Yunqi2001/TJU-PCB-2023/README.md

# 🤖 PCB Project 2023

Hii, here is Yunqi 🤠, I'm a designer :)  
This is my PCB (printed circuit board) project at the D&I, Tongji University.

Here I will show you how I learn the basics of electronic circuits design, fabrication and programming, and create my own smart device to strengthen the bonds between humans and nature.

The main tools used include [EDA](https://pro.lceda.cn/editor) for circuit design, [Arduino IDE](https://www.arduino.cc/en/software) for embedded programming, and the small CNC milling machine and electronic components available at [Fablab Shanghai](https://www.fablabs.io/labs/ShanghaiFablab) laboratory.

If you wanna learn and create your own PCB from scratch, things here can be a good reference.  
**If you only want to learn about my final output, please open the "final project" folder directly.**

Thanks for watching! <3

你好！我叫李蕴琦 🤠，我是一个设计师 :)  
这是我的PCB（印刷电路板）项目，作为在同济设创大四studio的课程产出。
我将在这里向你展示我学到的电路设计，制作和编程的知识，以及我是如何用它们设计、制作我自己的智能设备，来加强人与自然的连接的。

主要用到的工具有[EDA](https://pro.lceda.cn/editor)来设计电路,[Arduino IDE](https://www.arduino.cc/en/software)来做简单的嵌入式编程, 以及[Fablab Shanghai](https://www.fablabs.io/labs/ShanghaiFablab)实验室里的小型数控铣床和电子元器件们。

如果想你像我一样想从零开始学习、制作你自己的pcb，这会是一个不错的参考。  
**如果你仅仅想了解我的作品，请直接打开最后一个 “final project" 文件夹。**

感谢观看 <3
