Yunqi2001/TJU-PCB-2023/06-actuators/README.md

# Actuators

## Description
Sensors are INPUT devices, actuactors are OUTPUT devices. 
We use sensors to collect data, and use actuactors to translate the data we get to something humans can feel and understand. 
In this tryout, we learned about some actuators such as servo motor and I2C crystal screen. 

## Documentation
- control the servo motor with a variable resistor
<p align="left">
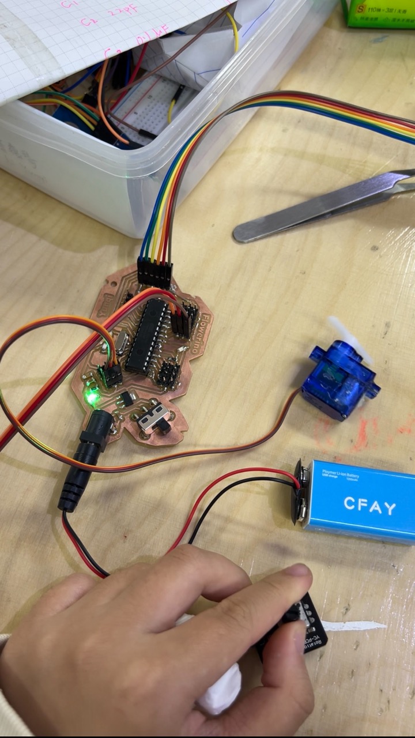
[picture p8: 06-actuators/images/IMG_3279.jpeg]
size limit image cant be show
	
</p>

- connect an I2C liquid crystal screen: SCI SDA RX TX pins make the chip inside I2C communicate with atmega
- include the I2C library
  <p align="left">
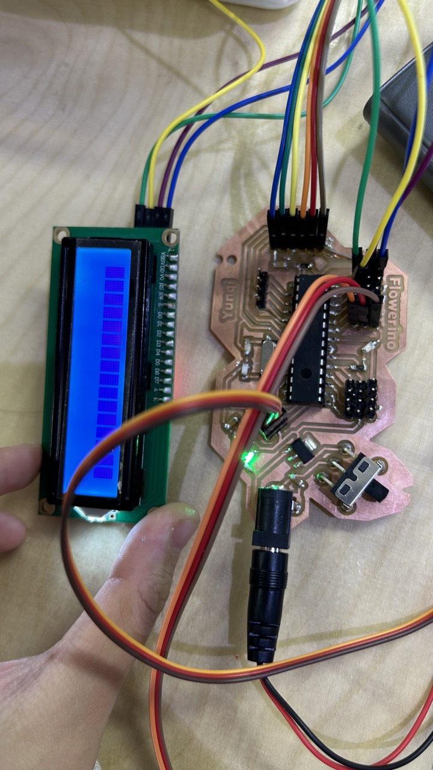
[picture p9: 06-actuators/images/IMG_2017.jpeg]
size limit image cant be show
	
</p>

- run the I2C scanner to get the address of your I2C
  <p align="left">
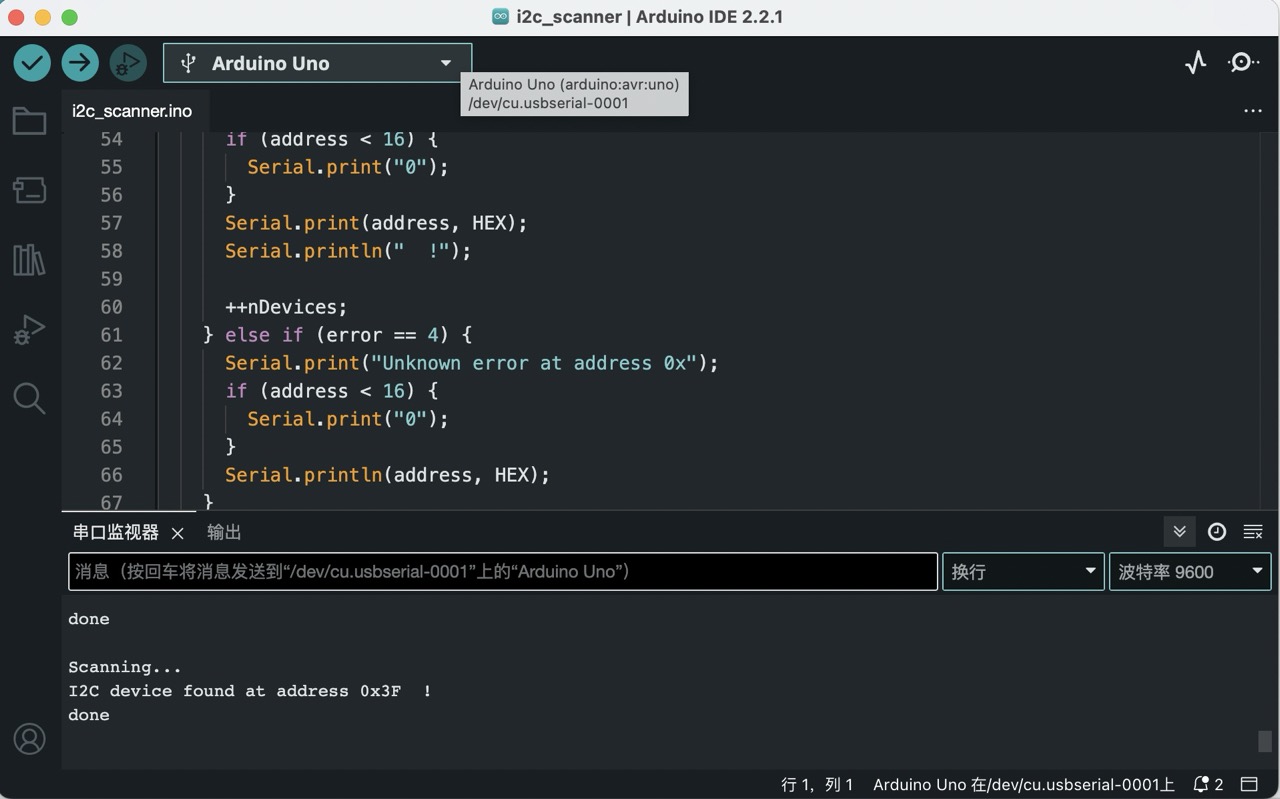
[picture p10: 06-actuators/images/i2c scanner.jpeg]
size limit image cant be show
	
</p>

- then you can show the message you want on the liquid screen
<p align="left">
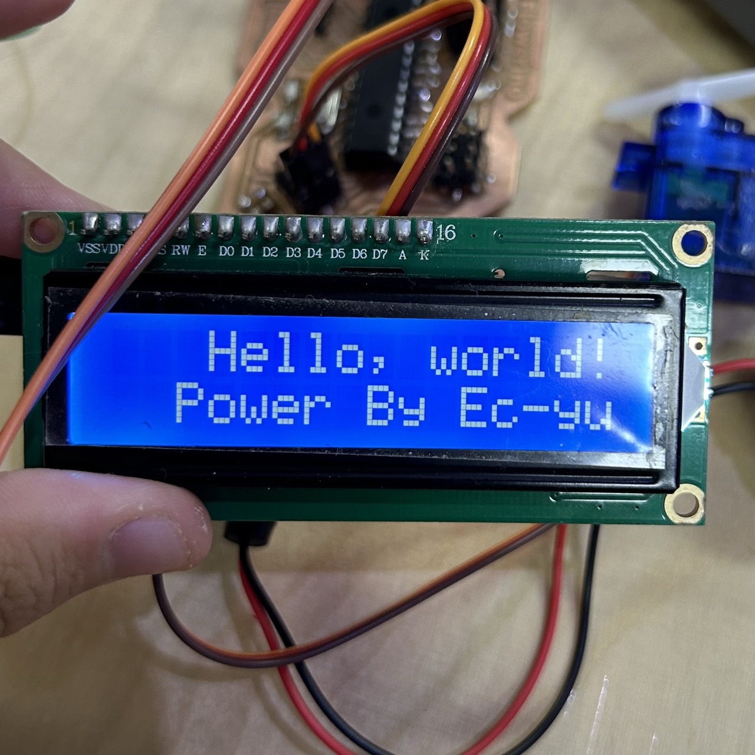
[picture p11: 06-actuators/images/IMG_2018.jpeg]
size limit image cant be show
	
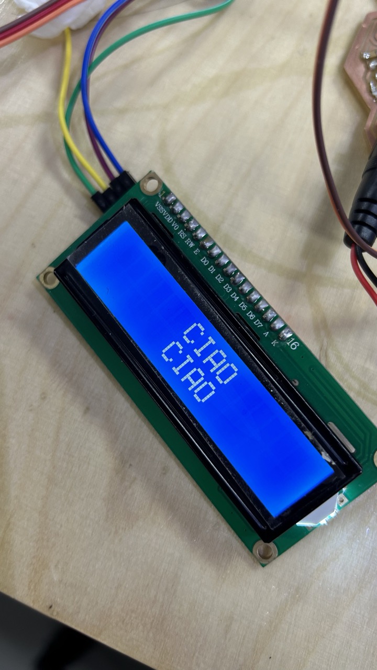
[picture p12: 06-actuators/images/IMG_2020.jpeg]
size limit image cant be show
	
</p>
