Yunqi2001/TJU-PCB-2023/05-cncmilling/README.md

# cncMilling

## Description
Time to create your own PCB! 
Design the circuit in easyEDA, cut the board with the cnc machine, and solder the components on it.

## circuit design in easyEDA
Firstly, put the components you need in the schematic, set the circuit connections between them.
<p align="center">
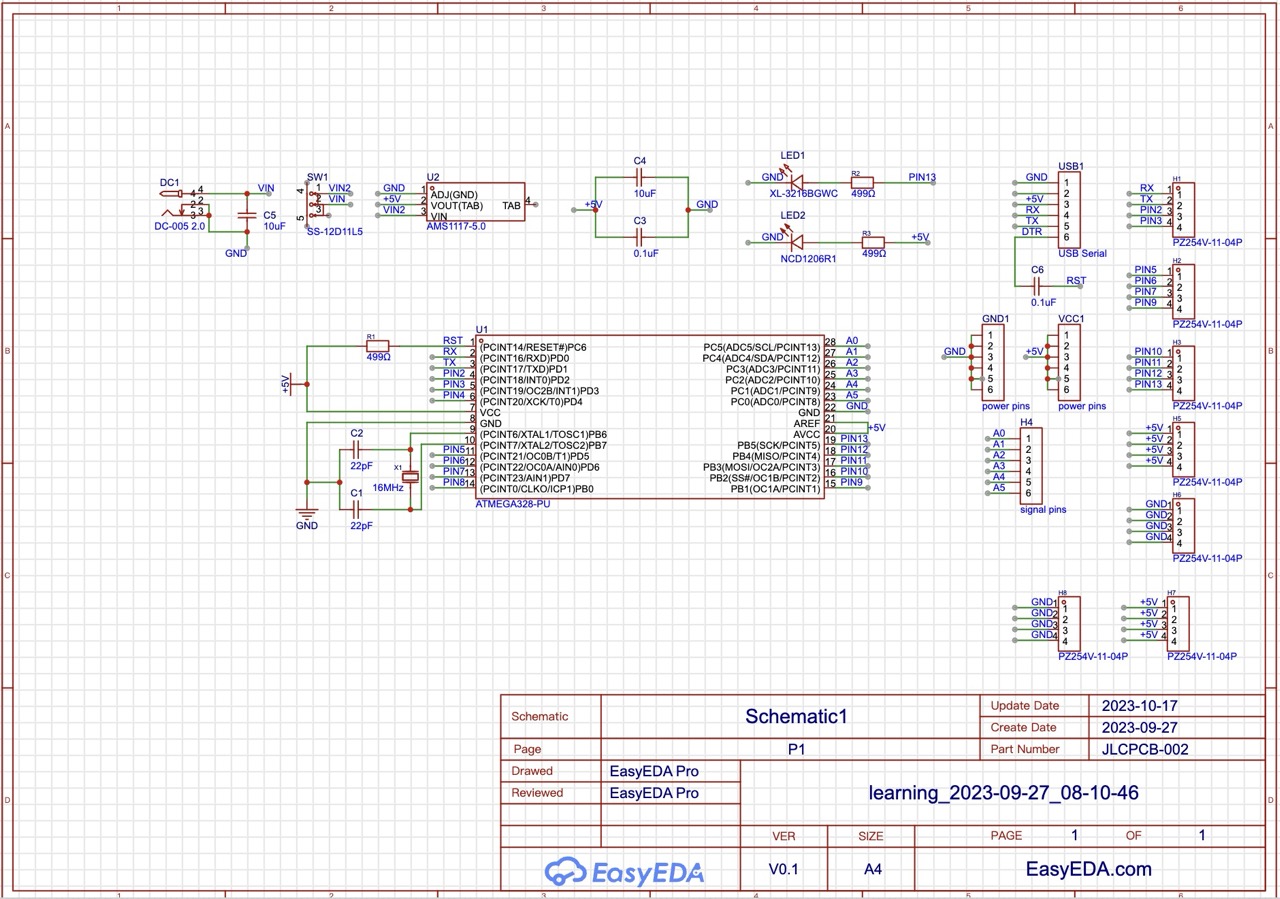
[picture p13: 05-cncmilling/images/schematic.jpeg]
size limit image cant be show
	
</p>
And then, in the PCB view, design the actual routing and the placement of components.  
It's a good idea to change the footprint of the components to a larger size, which will make soldering the components much easier.
<br/>
Actually in the beginning, I wanted to create a leaf-shaped design and drew a simple sketch with only components and the outline. However, during the wiring process, I realized I had to move some components around, and the traces took up more space than I assumed. So the final shape deviated from the original design a lot.
<p align="center">
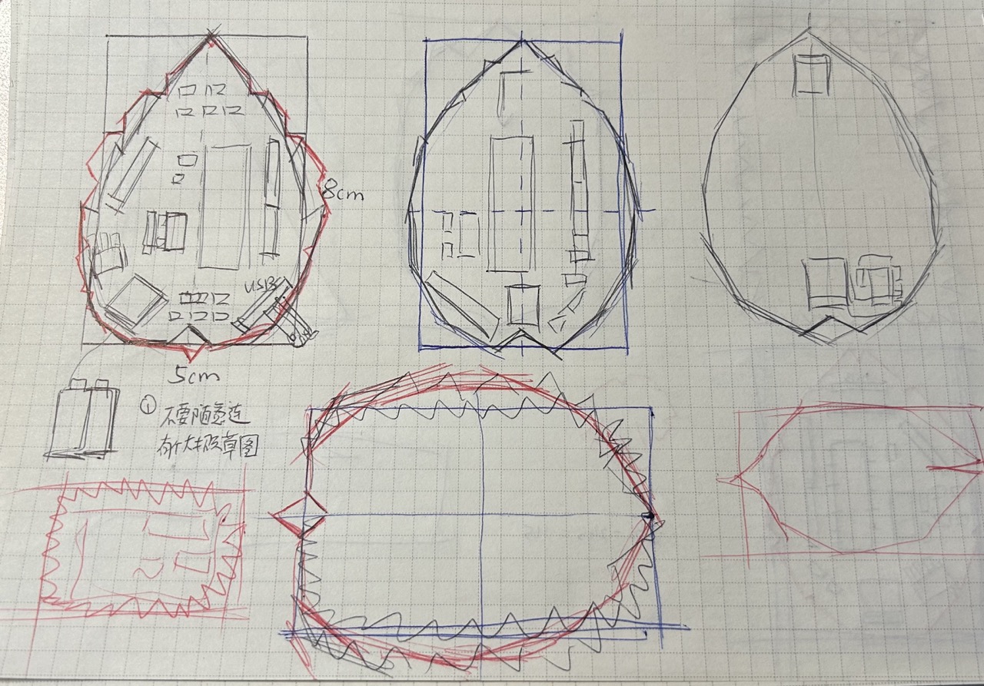
[picture p14: 05-cncmilling/images/IMG_3278.jpeg]
size limit image cant be show
	
</p>
<br/>
It's a good idea to start with a sketch, but always keep the traces in mind when your are sketching.
<br/>
I struggled a lot with defining the outline, trying to make it fit in the internal circuit and beautiful at the same time. I made a lot adjustments, you can see the evolving process in  the screeshots captured at different stages below.
<p align="center">
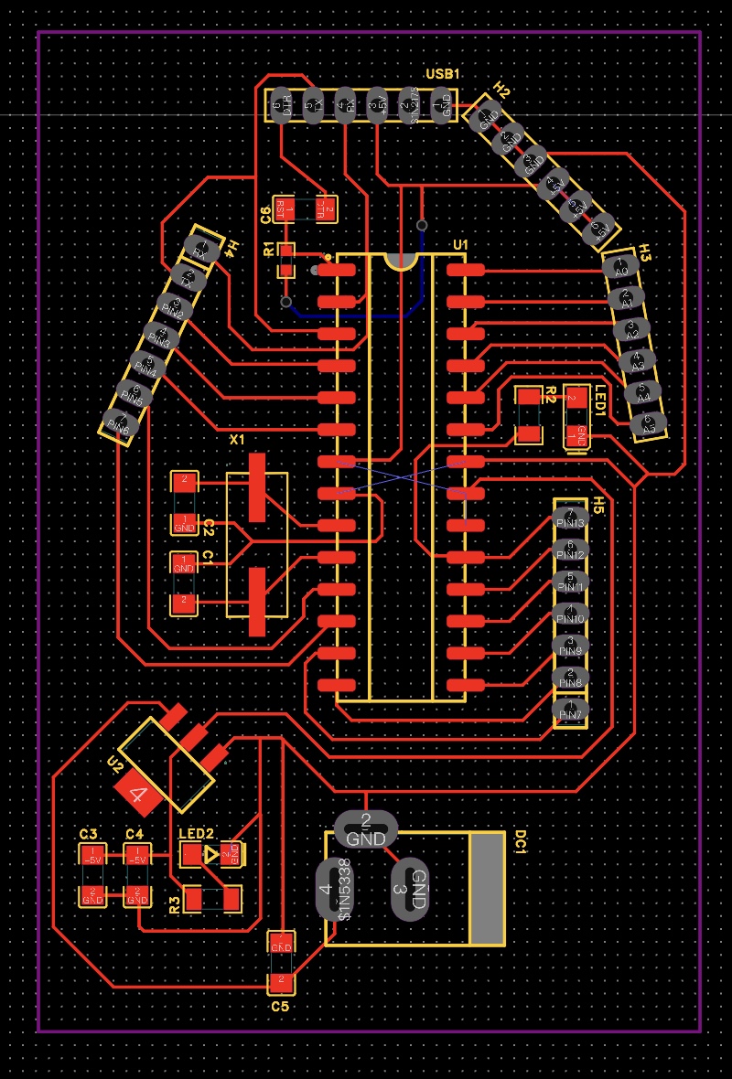
[picture p15: 05-cncmilling/images/1.JPG]
size limit image cant be show
	
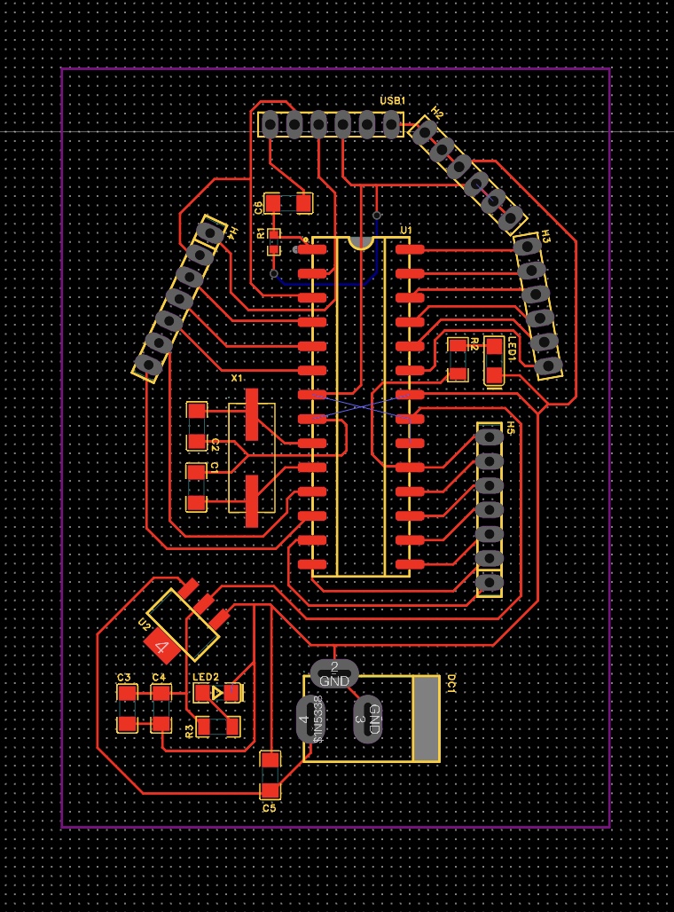
[picture p16: 05-cncmilling/images/2.JPG]
size limit image cant be show
	
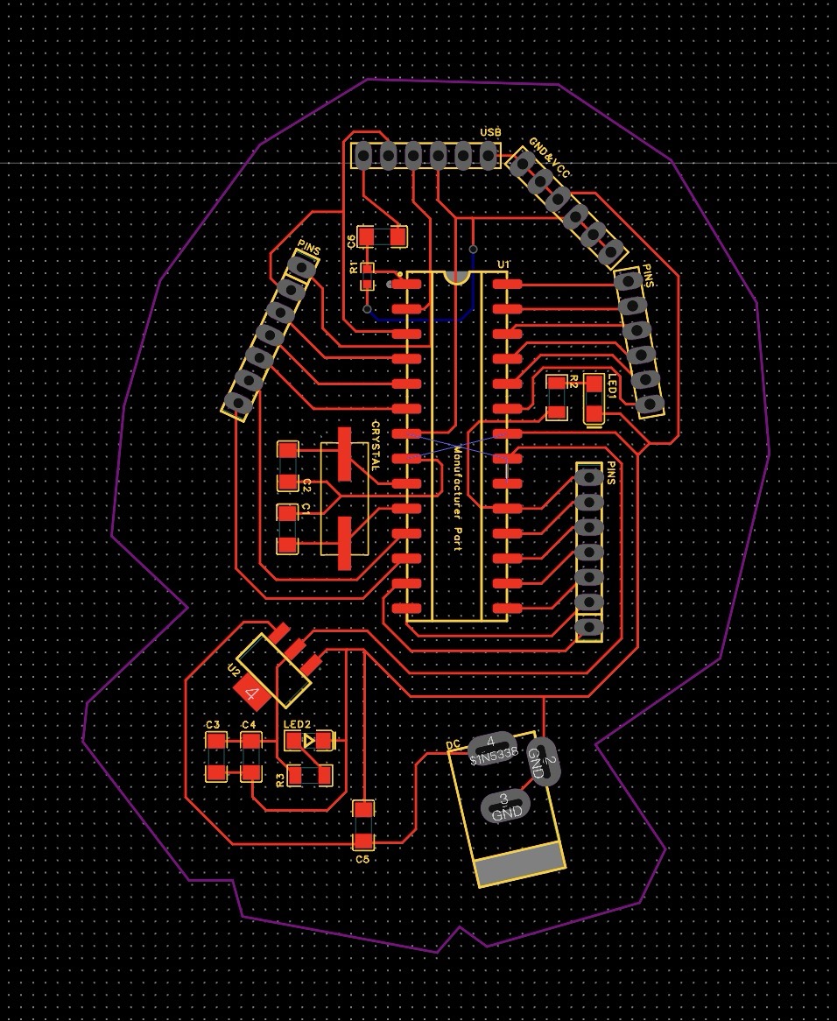
[picture p17: 05-cncmilling/images/jelly fish.jpeg]
size limit image cant be show
	
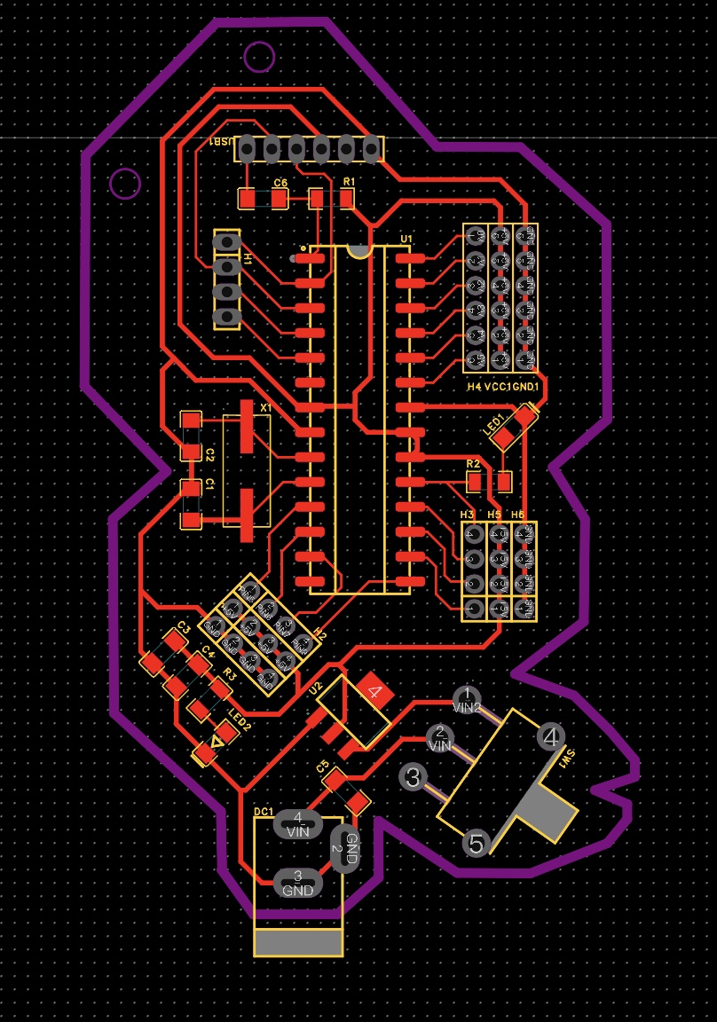
[picture p18: 05-cncmilling/images/final_design.JPG]
size limit image cant be show
	
</p>
The final shape looks like a flower with a leaf. So I call it flowerino :)

## get the cut file ready
Once the design is finalized, you can't cut the board directly.  
There are additional steps required to make the design understandable for the CNC machine:
1. export a white on black pdf file in easyEDA
2. open in the pdf file in adobe illustrator or other image-processing softwares (always remember to ensure the size is correct)
3. seperate out the three cut files for traces, holes and the outline. (we will use different endmills and cutting settings)
4. export the three PNG files **at a resolution of 1000dpi**
5. upload the three PNG file to get the rml files
<p align="center">
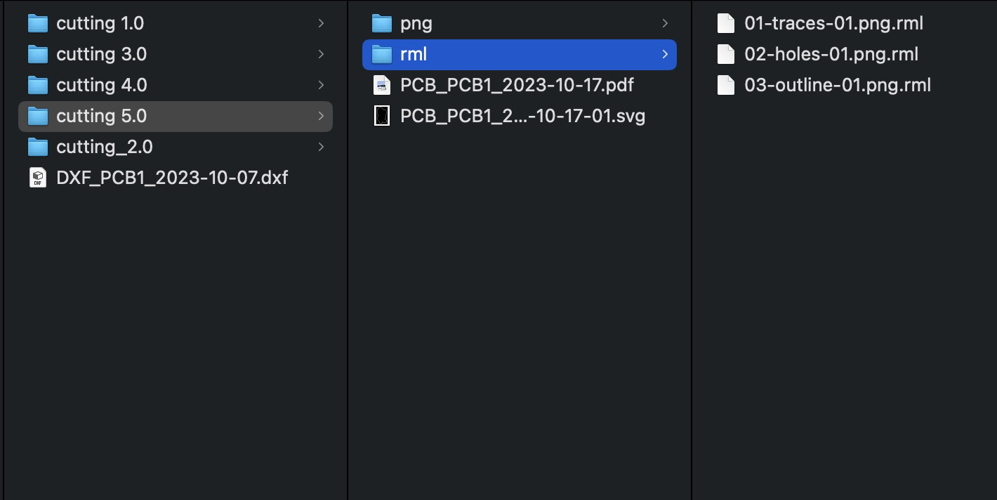
[picture p19: 05-cncmilling/images/files.jpeg]
size limit image cant be show
	
</p>

- I went through several iterations before obtaining the final cutting file that can be accurately processed. I consistently identified various oversights and issues, fortunately catching them in time before the actual cutting process. Anyway, you should have three rml files like this before you proceeding with the machine.
- One crucial point to note: ensure that the outline image does not touch the edges, or else it will not be cut properly
<p align="center">
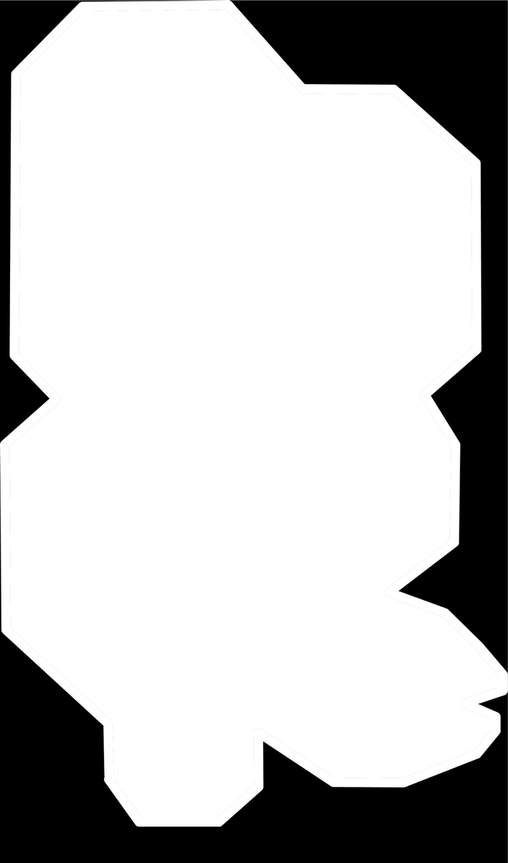
[picture p20: 05-cncmilling/images/outline.jpeg]
size limit image cant be show
	
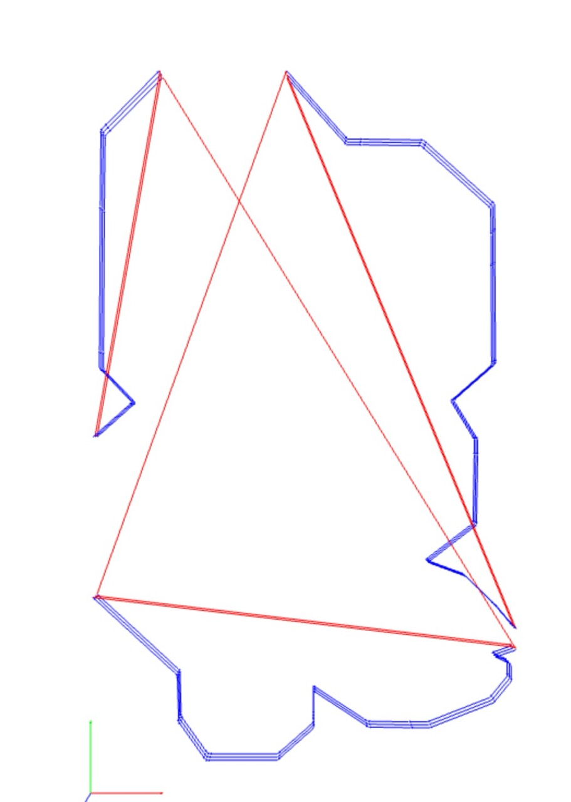
[picture p21: 05-cncmilling/images/outline issue.jpeg]
size limit image cant be show
	
</p>

## cut the board with CNC machine
- steps: place the copper board securely -> calibrate the zero coordinates for the x and y axes -> install the endmill -> calibrate the zero coordinates for the z-axis
<p align="center">
	<img src="./images/IMG_1728.jpeg") alt="size limit image cant be show" height="500"">
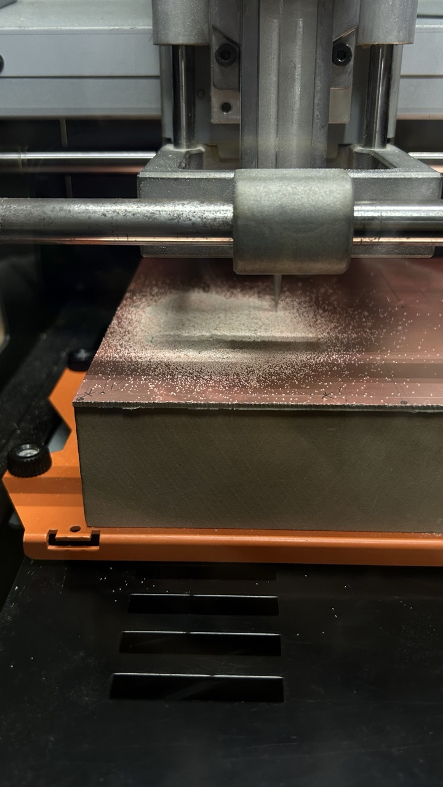
[picture p22: 05-cncmilling/images/IMG_1727.jpeg]
size limit image cant be show
	
</p>
<p align="center">
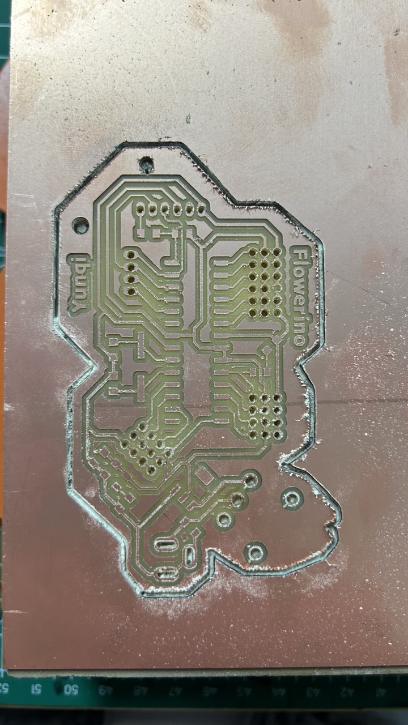
[picture p23: 05-cncmilling/images/IMG_1757.jpeg]
size limit image cant be show
	
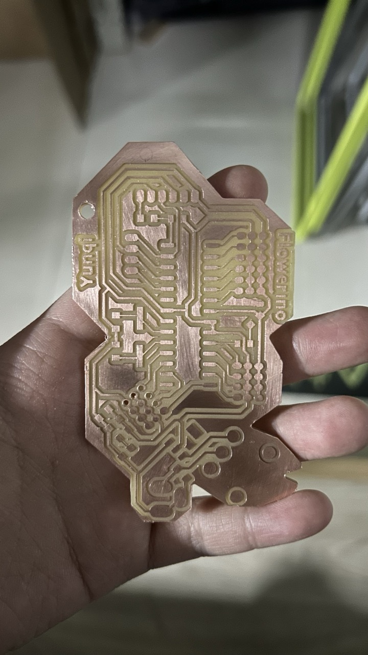
[picture p24: 05-cncmilling/images/IMG_1744.jpeg]
size limit image cant be show
	
</p>

- Two ways to verify that the cutting is proceeding correctly: (Stop the machine immediately and check if you sense any abnormalities!!)
	1. Listen: A light and smooth buzzing sound.  
	2. See:  If you see dust, it indicates that the cutting is on track.
- excessive load error: The machine got stuck during the cutting process, and at this point, the coordinates are completely misaligned. To resolve this, you need to restart the machine and initiate the cutting process anew. If you remember the initial setup and zero coordinate positions, you can continue cutting directly. However, if you don't recall the zero coordinate positions, you'll need to repeat the entire cutting operation. Therefore, it's a good idea to take photos or make records to save the set XYZ zero coordinates after configuring them initially.
<p align="center">
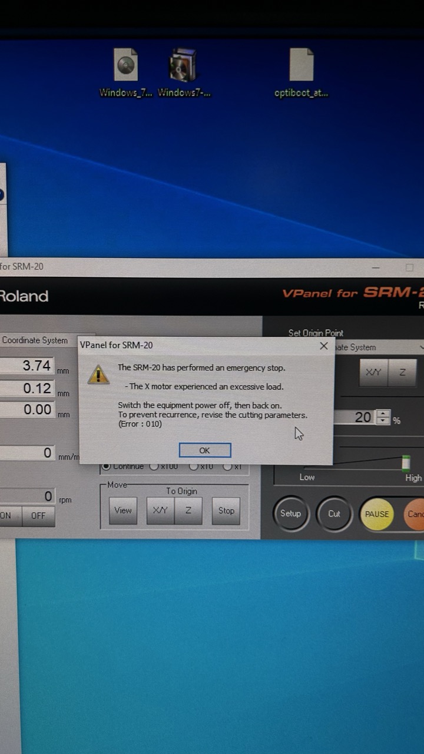
[picture p25: 05-cncmilling/images/IMG_1738.jpeg]
size limit image cant be show
	
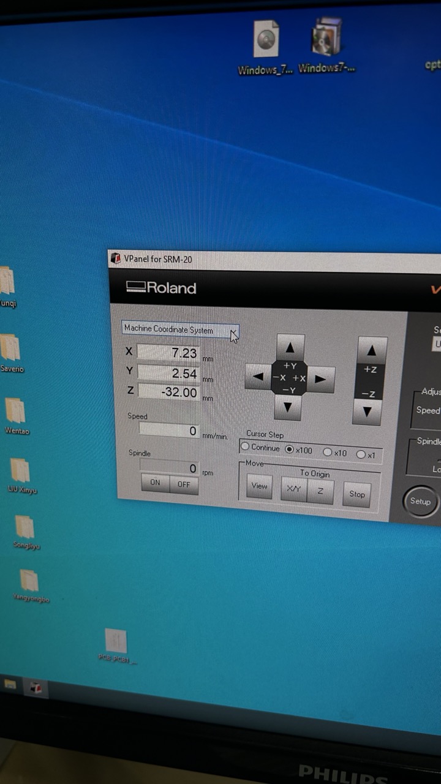
[picture p26: 05-cncmilling/images/IMG_1724.jpeg]
size limit image cant be show
	
</p>

## solder components 
- get your components ready
  <p align="left">
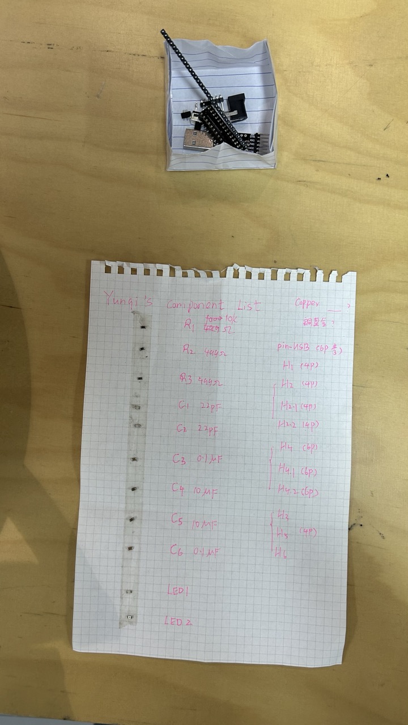
[picture p27: 05-cncmilling/images/IMG_1969.jpeg]
size limit image cant be show
	
</p>

- Never touch the soldering iron with your hands.
- Clean the soldering iron tip after soldering each component.
- Ensure the soldering iron makes simultaneous contact with the component and pad, apply heat for three seconds.
- Exercise extreme caution when soldering components on the copper board, especially to avoid breaking the solder pads. If, like me, you accidentally break the solder pads for the USB serial, you'll have no choice but to cut another piece.
- I cut three boards because initially, I made the holes too large, causing instability in holding the components, and I ended up breaking the copper pad for the USB serial twice. In honor of all the mistakes I made 😅👇
  <p align="center">
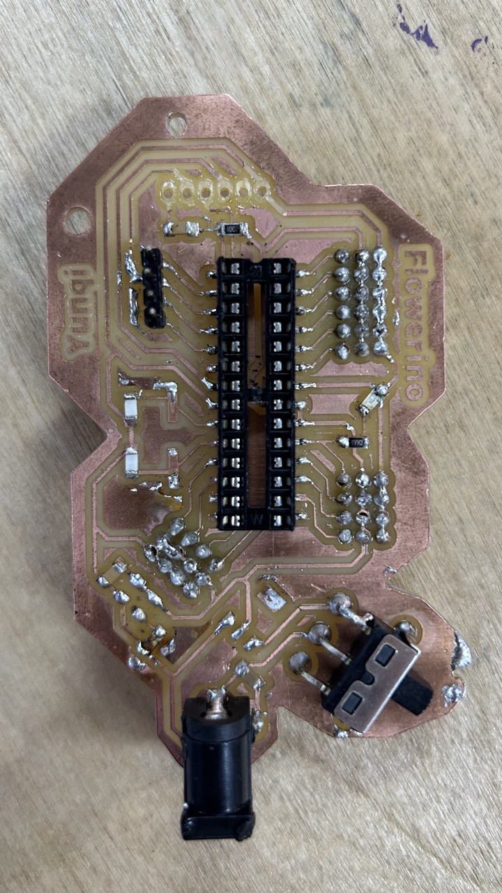
[picture p28: 05-cncmilling/images/IMG_1968.jpeg]
size limit image cant be show
	
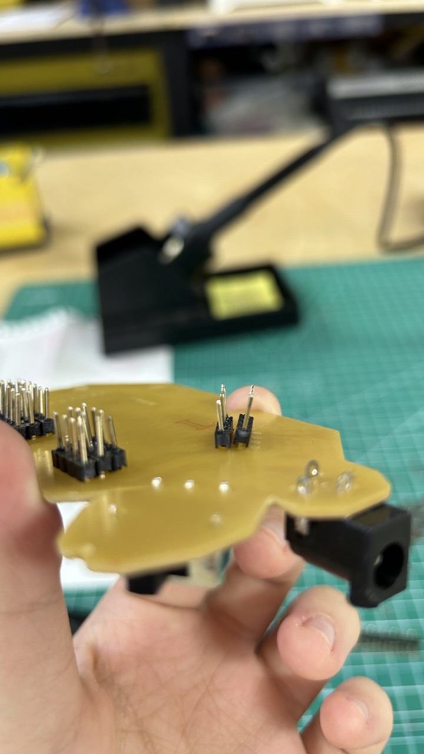
[picture p29: 05-cncmilling/images/IMG_1965.jpeg]
size limit image cant be show
	
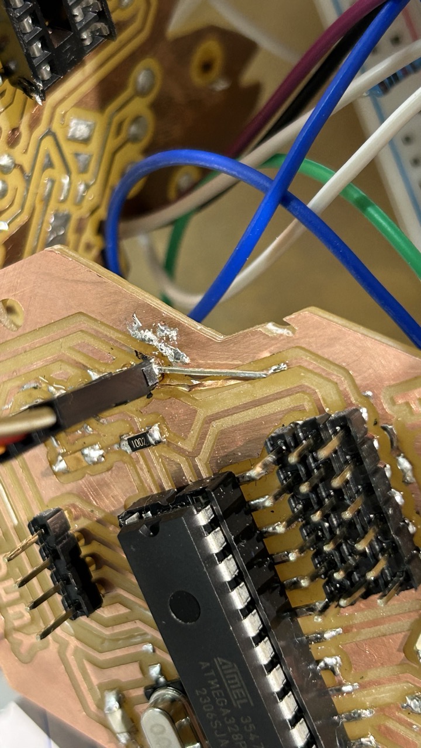
[picture p30: 05-cncmilling/images/IMG_1981.jpeg]
size limit image cant be show
 	
</p>

- After two scrapped boards, I finally got one that functions properly. 
<p align="center">
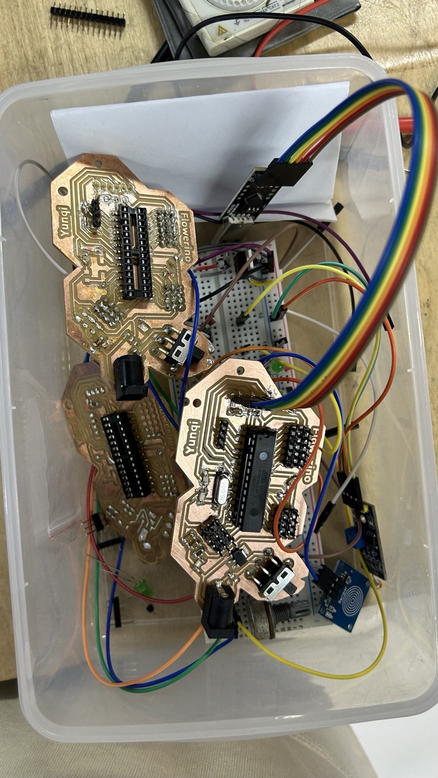
[picture p31: 05-cncmilling/images/IMG_1978.jpeg]
size limit image cant be show
  	
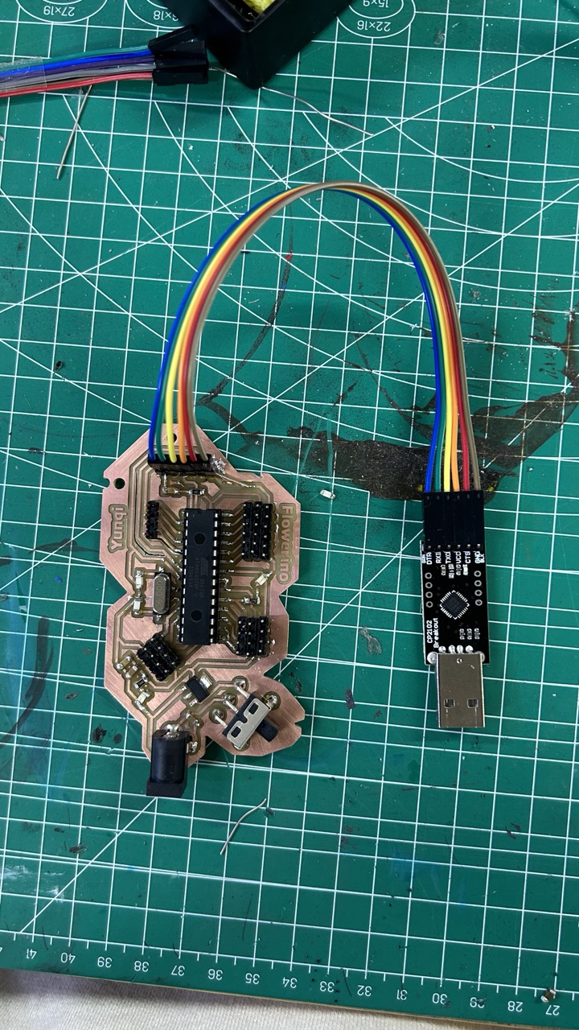
[picture p32: 05-cncmilling/images/IMG_1976.jpeg]
size limit image cant be show
   	
</p>
