Yunqi2001/TJU-PCB-2023/03-sensors/README.md

# Sensors Tryout

## A short Intro
Already have the basic components ready on your breadboard? In this experiment, we're diving into Arduino's input devices. I picked a light sensor to read analog signals from it, and a touch sensor to read digital signals.

## Necessary Knowledge
- Sensors usually have three pins: VCC, GND, and SIG, which connect to power, ground, and Arduino pins separately.
<p align="left">
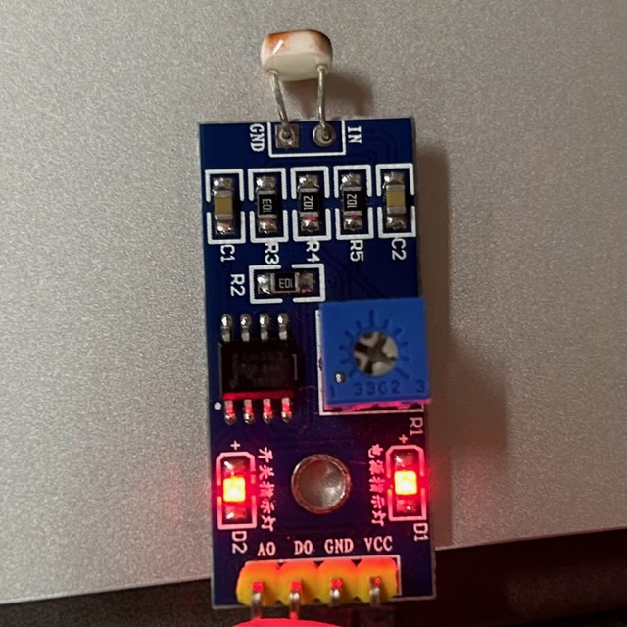
[picture p34: 03-sensors/images/IMG_0723.jpeg]
size limit image cant be show
	
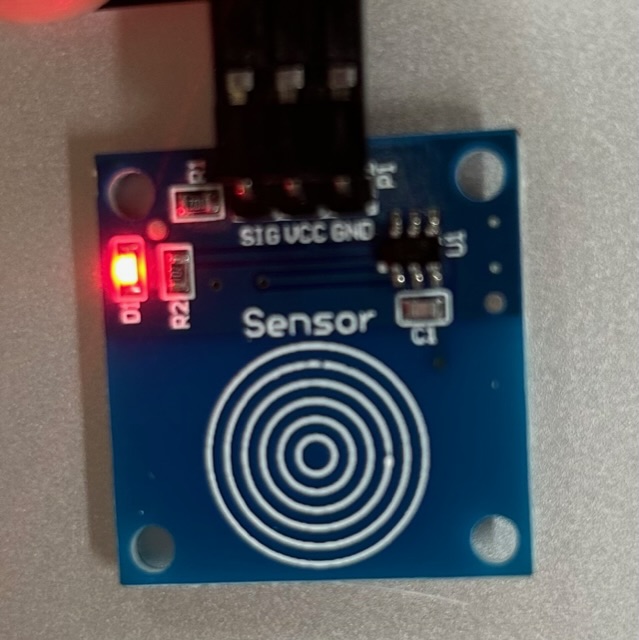
[picture p35: 03-sensors/images/IMG_0722.jpeg]
size limit image cant be show
	
</p>

- If you're using a two-pin sensor, hook one pin up to power and the other to an Arduino pin. **And don't forget to link a ground wire to that same Arduino pin's side.**
<p align="left">
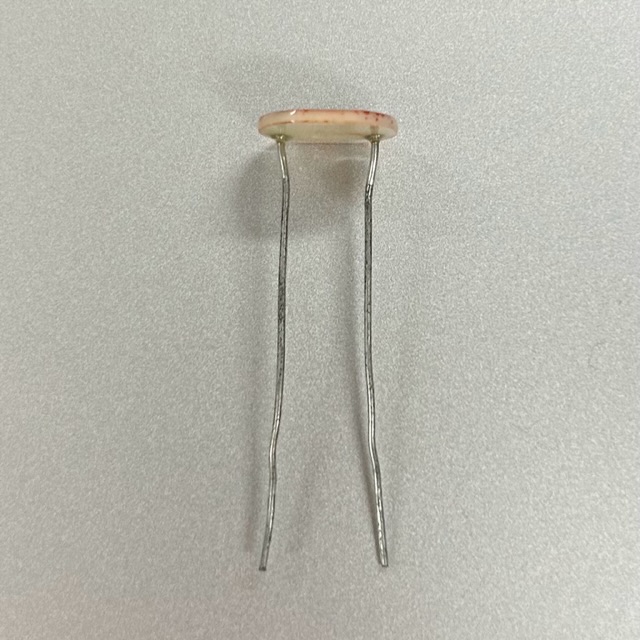
[picture p36: 03-sensors/images/IMG_0729.jpeg]
size limit image cant be show
	
</p>

## My Process 
At first, I plugged the touch sensor into pin 4. But, surprise, the touch sensor readings stayed the same. I checked the Arduino docs and found out that pin 4 is for analog input. So, I moved the touch sensor to pin 12, a digital input pin, and it worked! But then, I dug deeper and learned that analog pins can also handle digital signals. So, I tried the touch sensor again on an analog pin, and this time it worked. That initial problem was probably a hardware connection problem.

Remember, on the Arduino board, there are two kinds of interfaces to keep in mind: digital and analog. For beginners, you'd better use digital pins for handling digital signals (input and output) and analog pins for dealing with analog signals (input and output). This approach simplifies things and helps you get started more smoothly.
<p align="left">
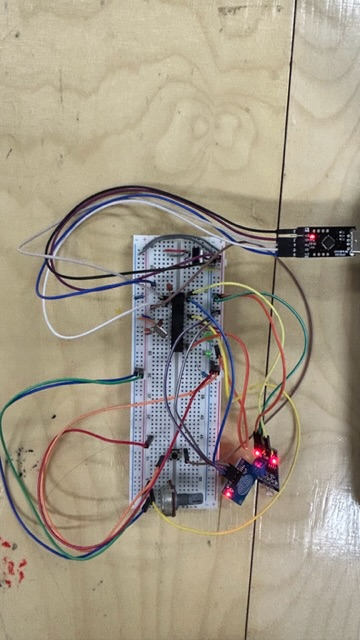
[picture p37: 03-sensors/images/IMG_0726.jpeg]
size limit image cant be show
	
</p>
