Yunqi2001/TJU-PCB-2023/08-finalproject/poster.pdf

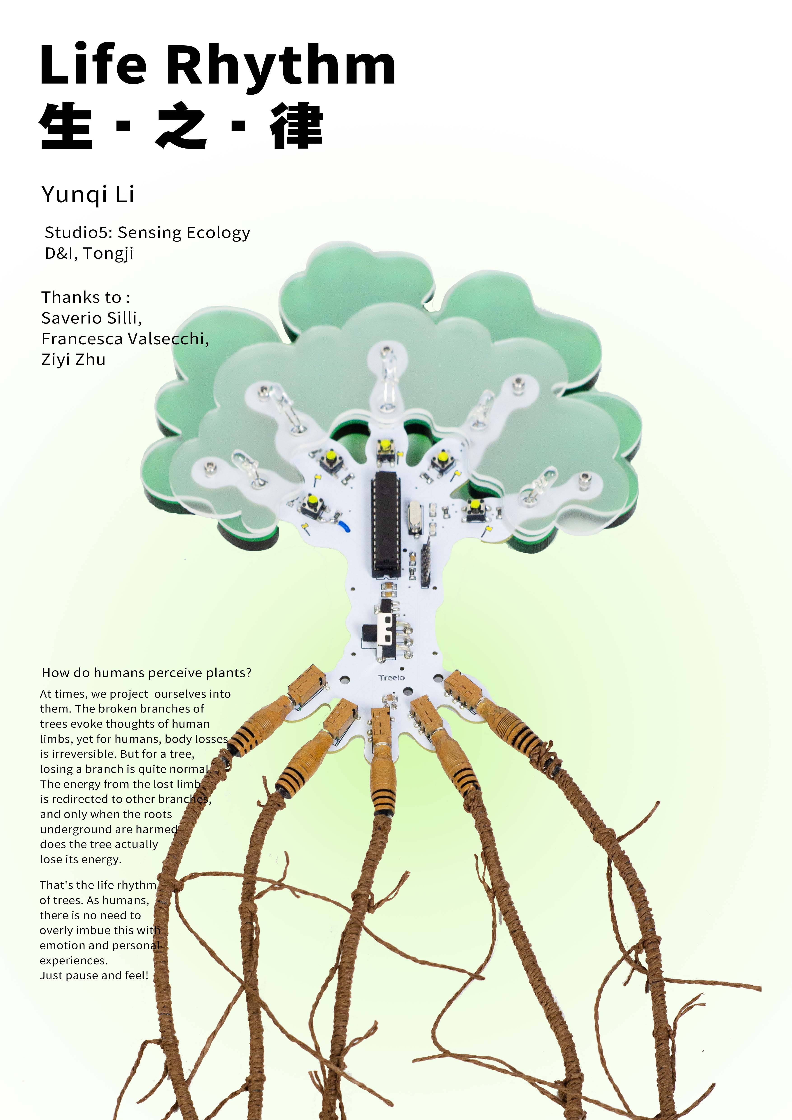
[picture p83: page 1]
