Yunqi2001/TJU-PCB-2023/01-breadboard/images/example.jpg

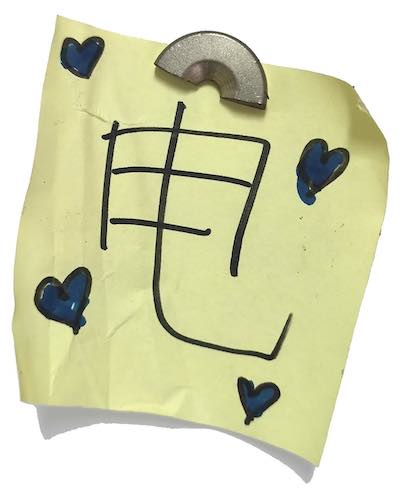
01-breadboard/images/example.jpg
