Yunqi2001/TJU-PCB-2023/04-exploration/images/IMG_0242.jpeg

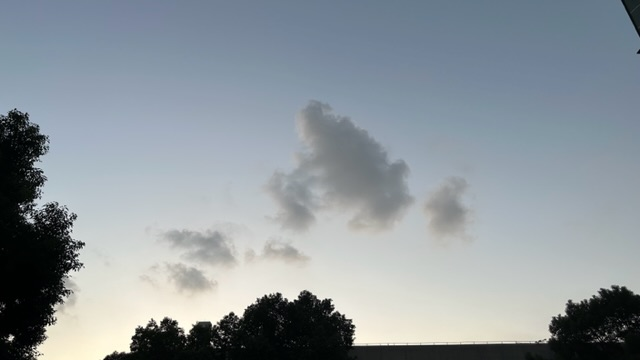
04-exploration/images/IMG_0242.jpeg
