Yunqi2001/TJU-PCB-2023/05-cncmilling/images/IMG_1728.jpeg

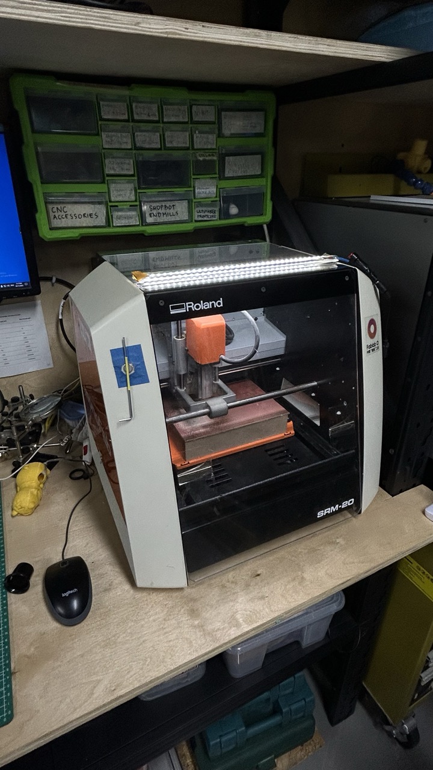
05-cncmilling/images/IMG_1728.jpeg
