Yunqi2001/TJU-PCB-2023/06-actuators/images/IMG_2019.jpeg

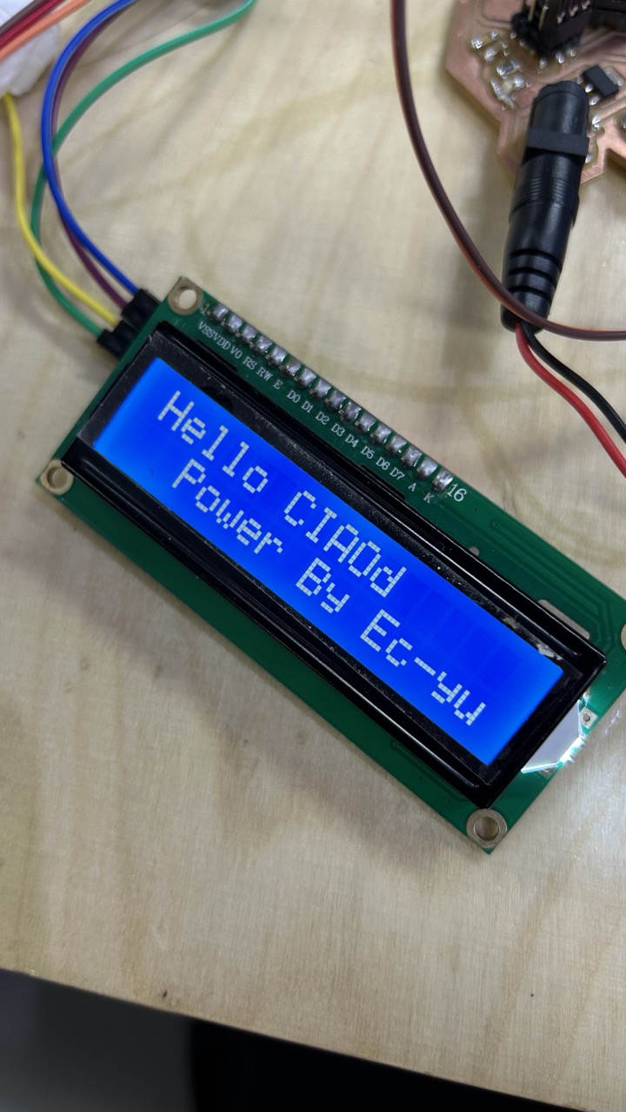
06-actuators/images/IMG_2019.jpeg
