Yunqi2001/TJU-PCB-2023/07-prototyping/images/IMG_2199.jpeg

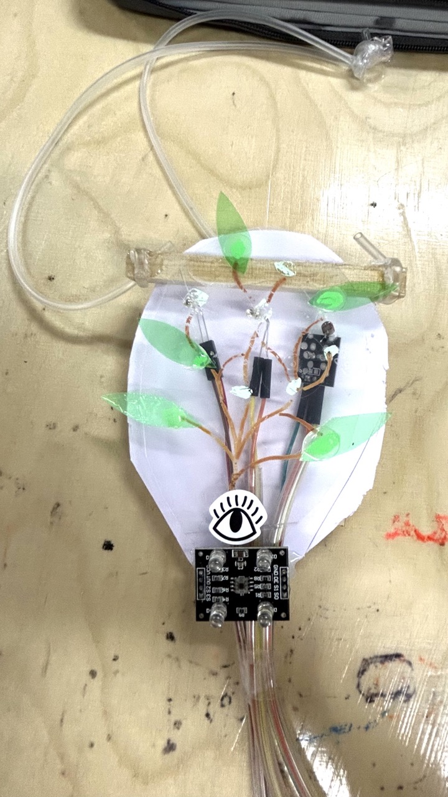
07-prototyping/images/IMG_2199.jpeg
