Yunqi2001/TJU-PCB-2023/08-finalproject/pics/10.jpg

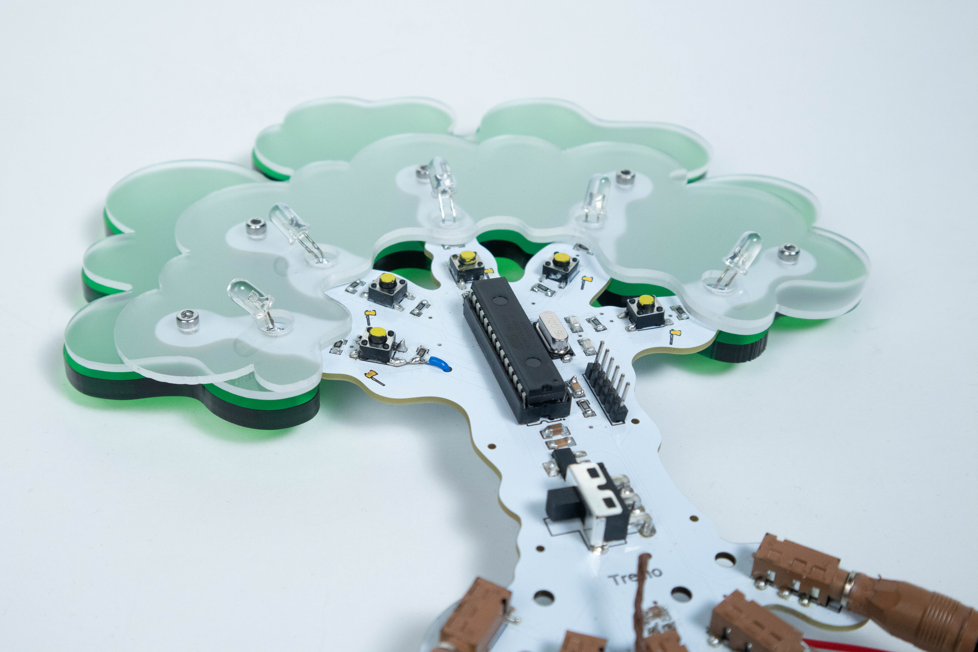
08-finalproject/pics/10.jpg
